74th/stm32-promicro/README.md

# STM32 ProMicro size Board

- STM32F103 -> see [x32micro](https://github.com/74th/x32promicro)
- [STM32G030F6P4](stm32g03xfxp)
- [STM32G431C8U6](stm32g431cxux)
