74th/stm32-promicro/stm32g431cxux/README.md

# STM32G431CxUx ProMicro

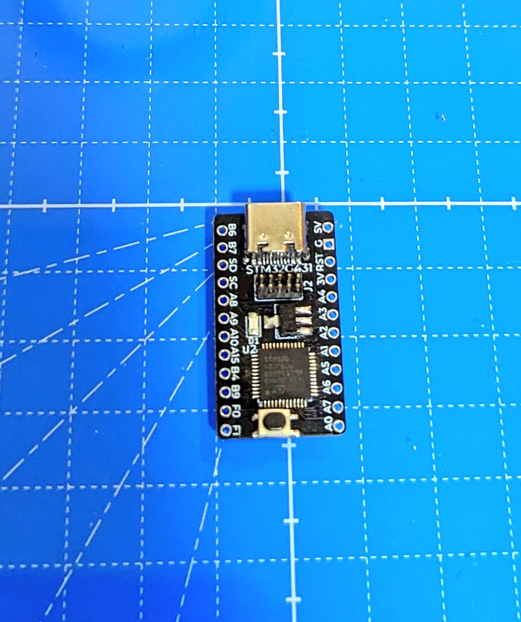
[picture p1: stm32g431cxux/photo1.jpeg]
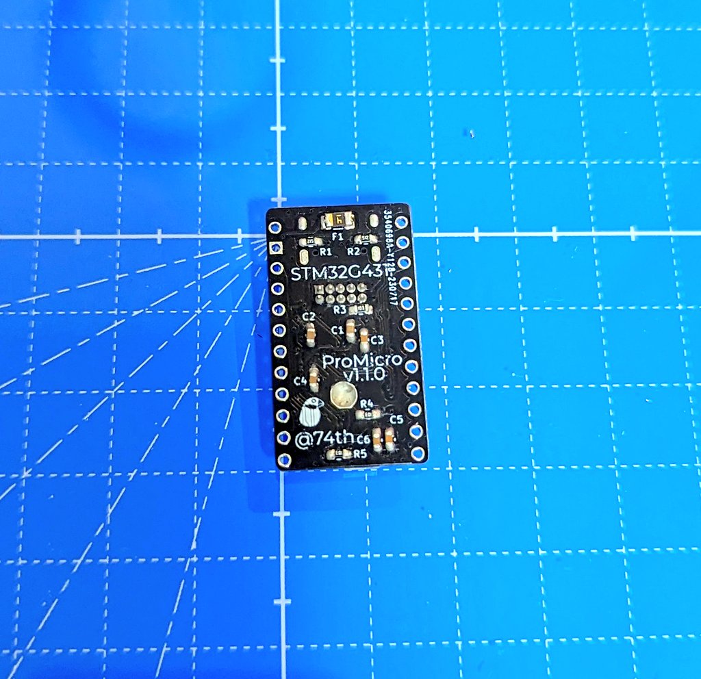
[picture p2: stm32g431cxux/photo2.jpeg]
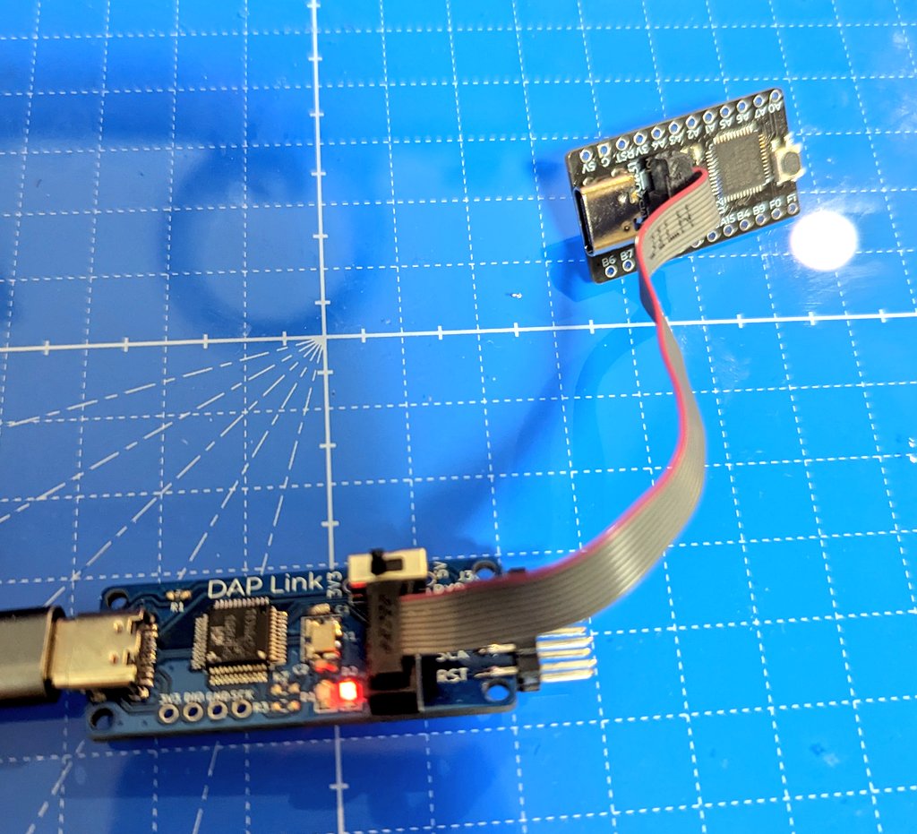
[picture p3: stm32g431cxux/photo3.jpeg]


## v1.1.0

### Documents

- semantics [PDF](./stm32g431-promicro-v1.1.0.pdf) [kicanvas](https://kicanvas.org/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)
- pcb [kicanvas](https://kicanvas.org/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)

### Pin Map

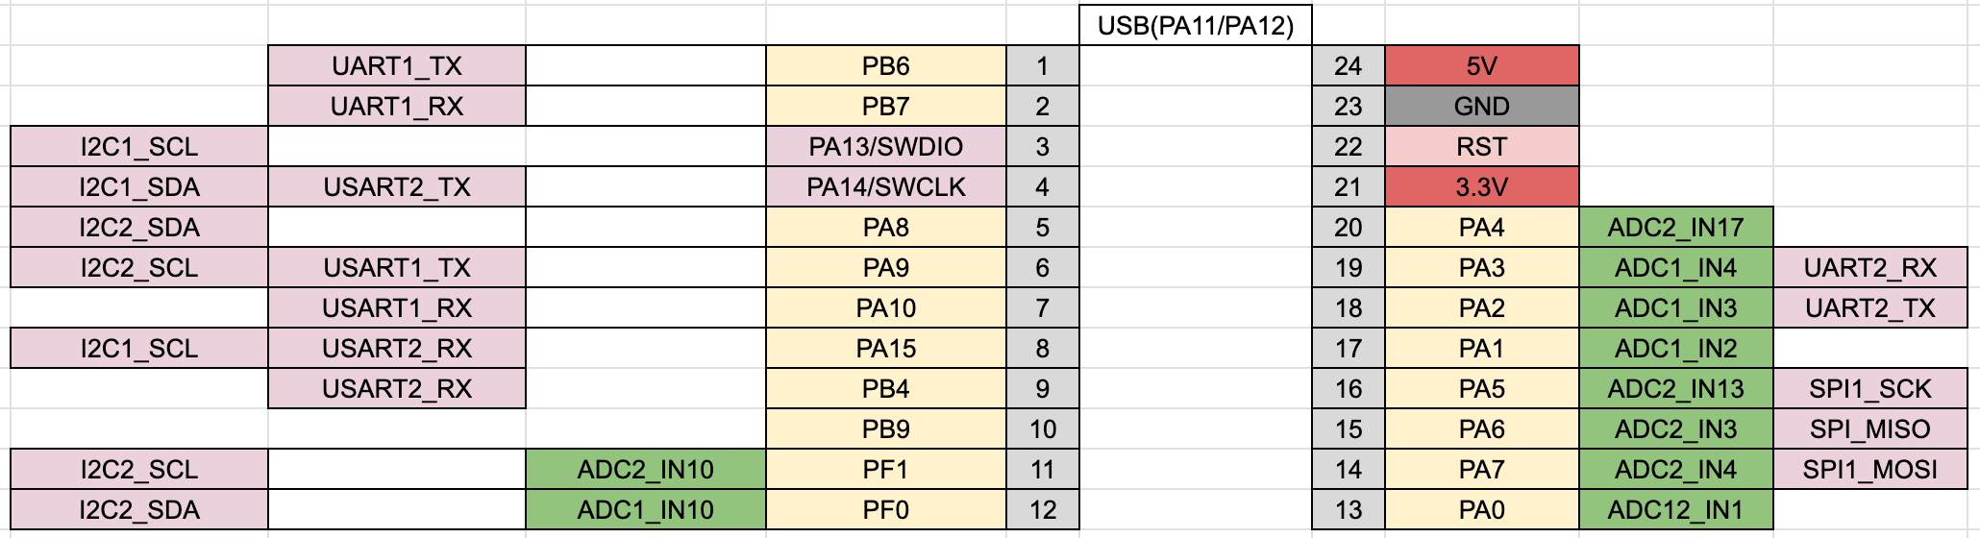
[picture p4: stm32g431cxux/pinmap-v1.1.0.png]


### errorta

- Silk on board has F0 and F1 reversed. ボード上のシルクに F0 と F1 が逆になっています。

### BOM

| Reference | Name | Quantity |
| --- | --- | --- |
| C1, C2 | Capacitor 0603 10uF | 2 |
| C3-C6 | Capacitor 0603 100nF | 4 |
| D1 | LED 0805 Blue | 1 |
| F1 | PolyFuse 1206 Polyfuse | 1 |
| J1 | USB Type-C Receptacle | 1 |
| J2 | Box Pin Header 2x5 Pitch 1.27mm | 1 |
| R1, R2 | Register 0603 5.1kΩ | 2 |
| R3-R5 | Register 0603 10kΩ | 3 |
| SW1 | Button SKRPABE010 | 1 |
| U1 | Regulator 3.3V SOT-89 AMS1117-3.3 | 1 |
| U2 | MCU UFQFPN48 ST STM32G431CBUx | 1 |
