74th/stm32-promicro/stm32g03xfxp/README.md

# STM32F03xfxp ProMicro

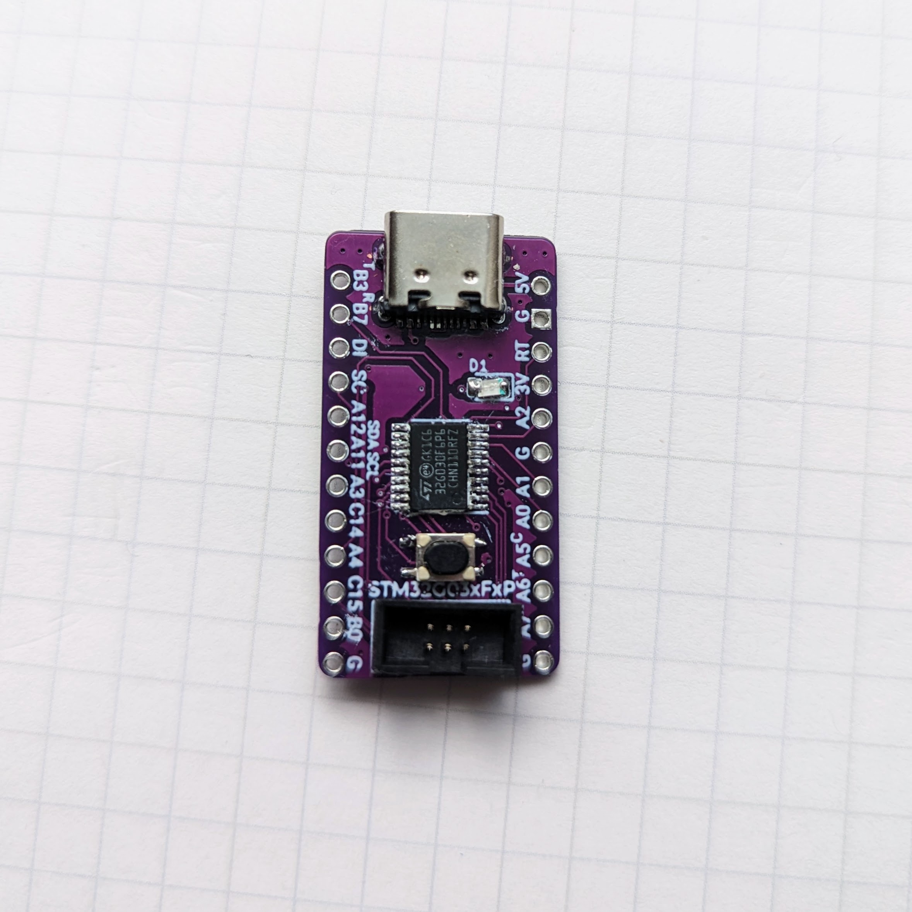
[picture p5: stm32g03xfxp/stm32g03xfxp-v1.2.0-photo1.jpg]
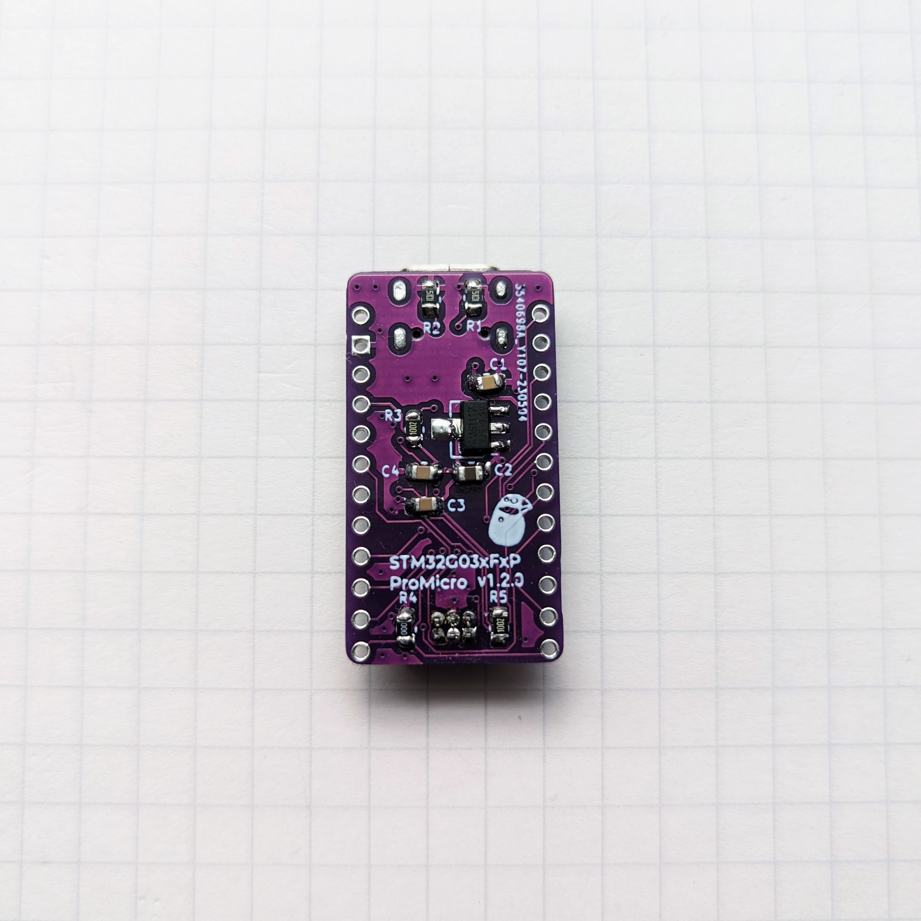
[picture p6: stm32g03xfxp/stm32g03xfxp-v1.2.0-photo2.jpg]
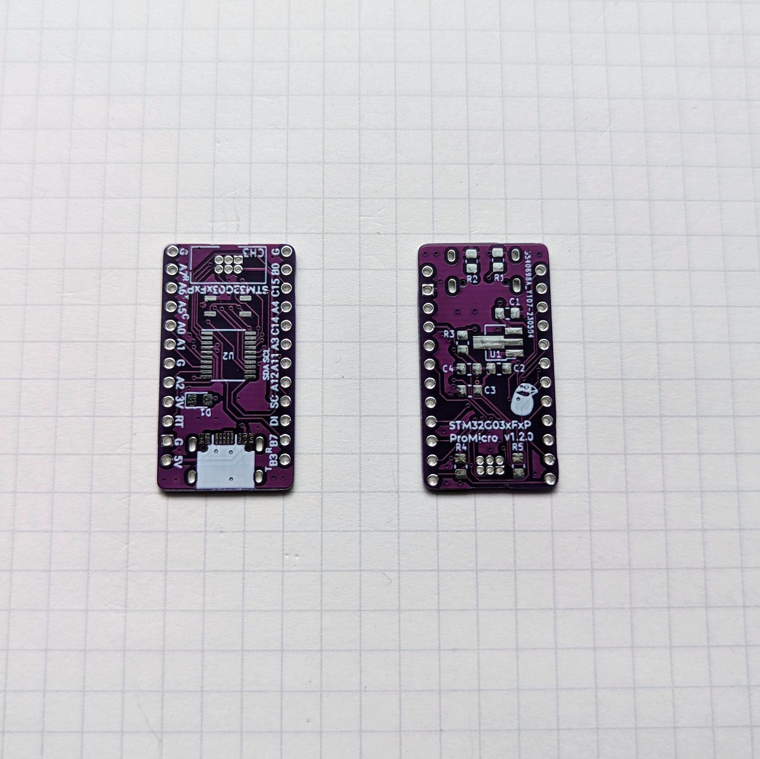
[picture p7: stm32g03xfxp/stm32g03xfxp-v1.2.0-photo3.jpg]
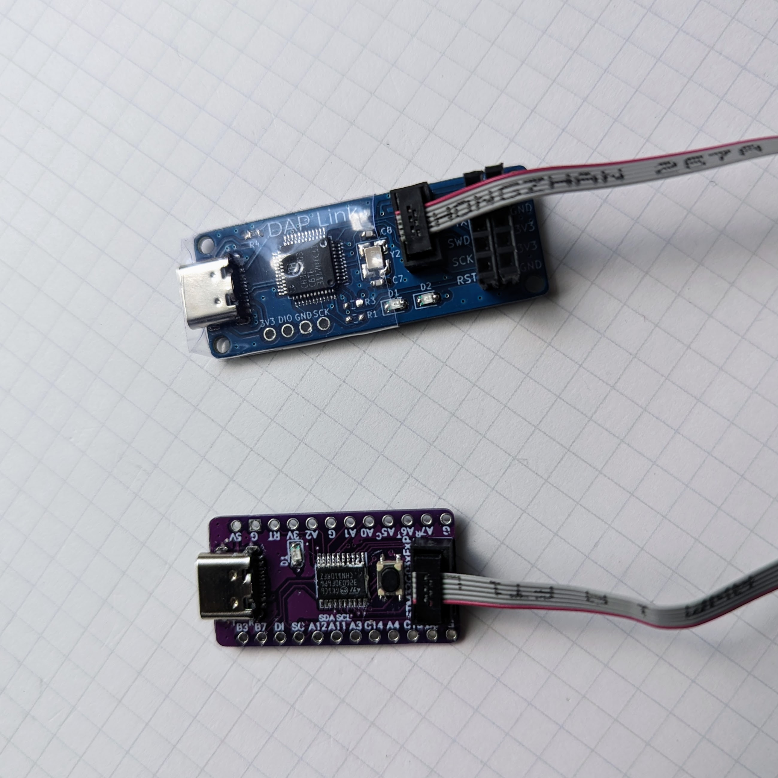
[picture p8: stm32g03xfxp/stm32g03xfxp-v1.2.0-photo4.jpg]


## v1.3.0

- change SWD port to 10 Pin with UART like Arduino UNO R4 (but, vcc is 3.3V)

### Documents

- Semantics 回路図 [PDF](stm32g03xfxp-semantcs-v1.3.0.pdf) [kicanvas](https://kicanvas.org/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)
- PCB [kicanvas](https://kicanvas.org/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)

### Debug Port

The box pin header for SWD has the following pin layout.

SWD のピンヘッダは以下のピン配置になっています。

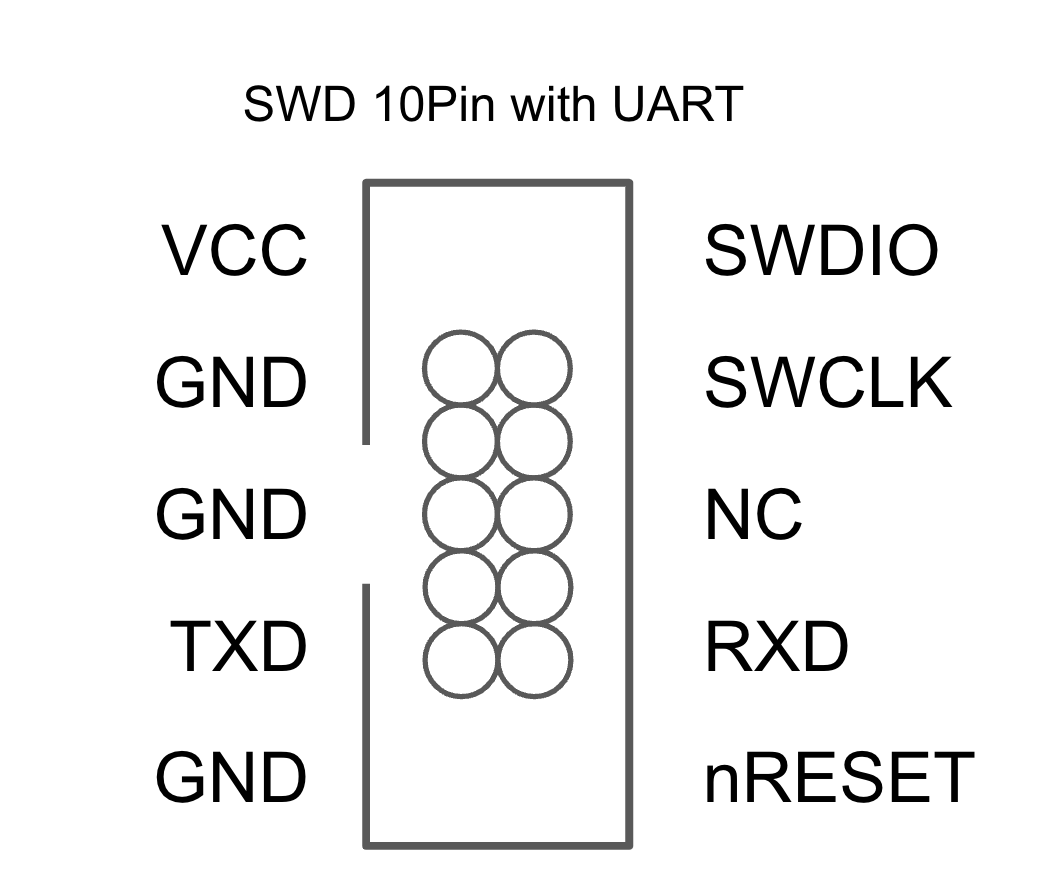
[picture p9: swd-with-uart-10pin.png]


## Pinout

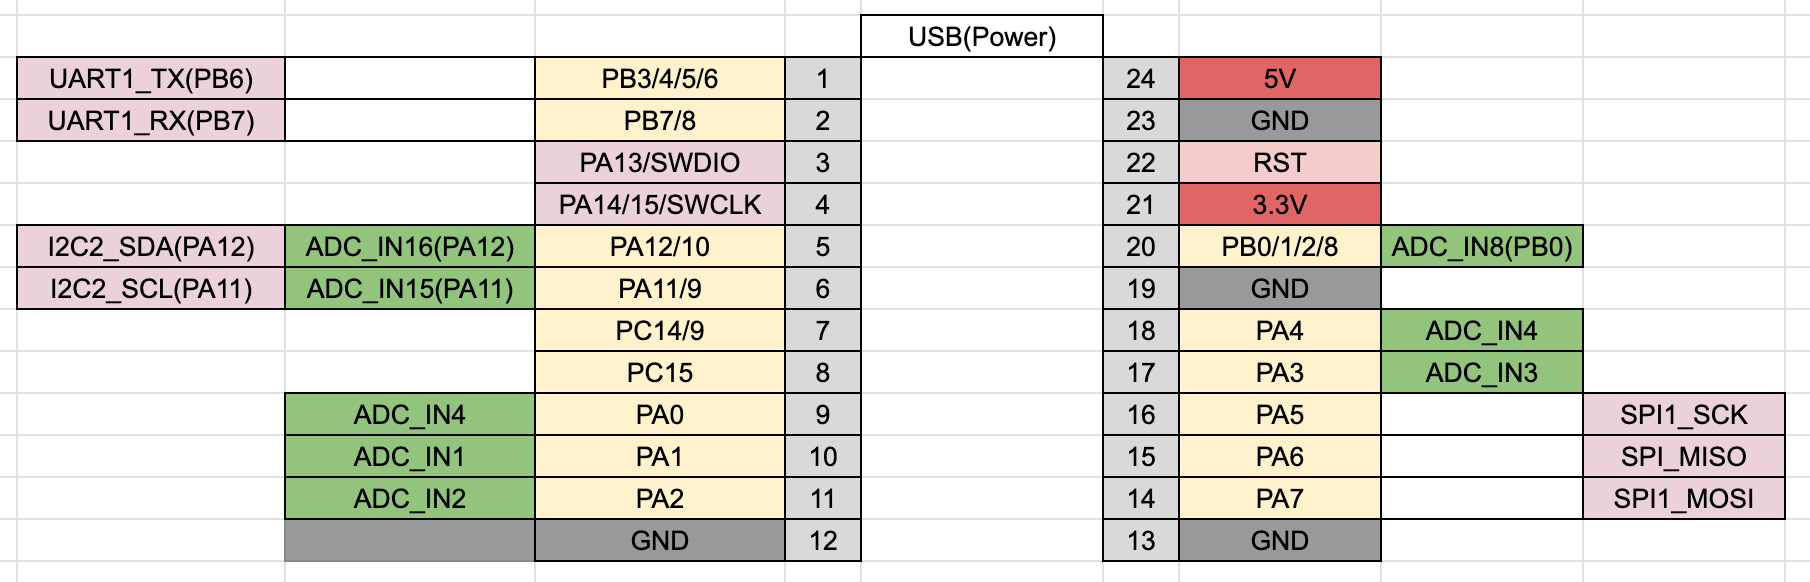
[picture p10: stm32g03xfxp/pinmap-v1.3.0.png]


For other functions, please refer to the datasheet.

他の機能はデータシートを参照ください。

### BOM

| Reference | Name | Quantity |
| --- | --- | --- |
| C1 | Capacitor 0805 10uF | 1 |
| C2 | Capacitor 0805 2.2uF | 1 |
| C3, C4 | Capacitor 0805 100nF | 2 |
| D1 | LED 0805 Blue | 1 |
| J1 | USB Type-C Receptacle | 1 |
| J2 | Pin Header 2x5 Pitch 1.27mm (SWD) | 1 |
| R1, R2 | Register 0805 5.1kΩ | 2 |
| R3, R4 | Register 0805 10kΩ | 2 |
| SW1 | Button SKRPABE010 | 1 |
| U1 | Regulator 3.3V SOT-89 AMS1117 | 1 |
| U2 | MCU ST STM32G030F6Px | 1 |

## v1.2.0

### Documents

- Semantics 回路図 [PDF](stm32g03xfxp-semantcs-v1.2.0.pdf) [kicanvas](https://kicanvas.org/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)
- PCB [PDF](stm32g03xfxp-pcb.pdf) [kicanvas](https://kicanvas.org/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)

### Debug Port

The box pin header for DAP Link has the following pin layout.

DAP Link 用のボックスピンヘッダは以下のピン配置になっています。

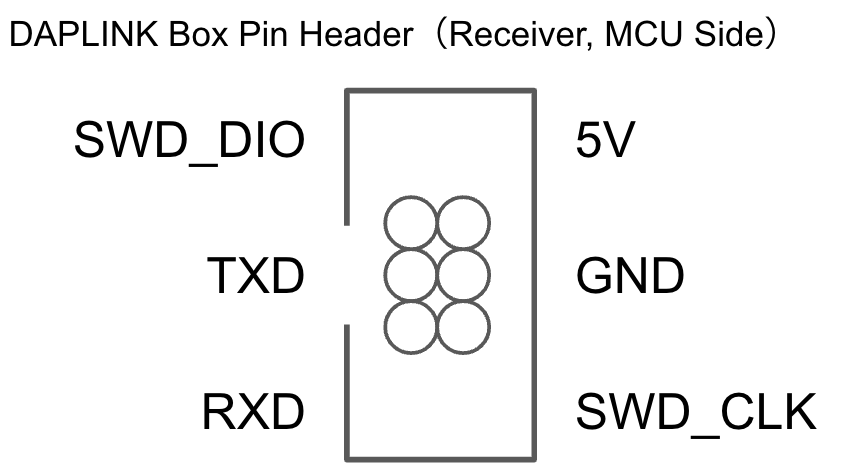
[picture p11: daplink-boxpinheader-receiver-6pin.png]


### Pinout

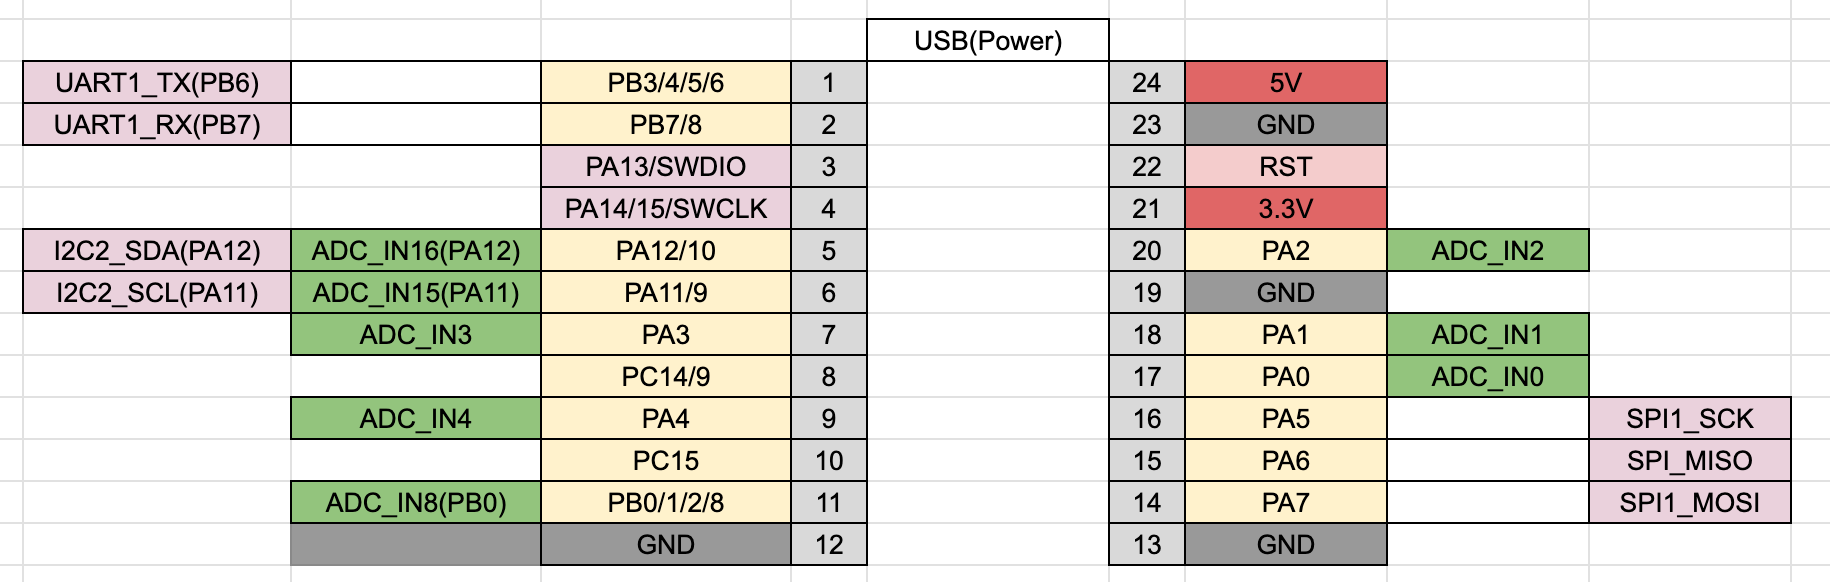
[picture p12: stm32g03xfxp/pinmap-v1.2.0.png]


For other functions, please refer to the datasheet.

他の機能はデータシートを参照ください。

### BOM

| id | parts name | num |
| ----- | --- | --- |
| J1 | USB 2.0 Type-C Socket (Only Power) | 1 |
| R1,R2 | 0806 Register 5.1k | 2 |
| R4 | 0806 Register 0 | 1 |
| R3,R6 | 0806 Register 10k | 2 |
| C1 | 0806 Capacitor 10u | 1 |
| C2 | 0806 Capacitor 2.2u | 1 |
| C3,C4 | 0806 Capacitor 100n | 2 |
| U2 | TSSOP-20 MCU STM32G030F6Px | 1 |
| D1 | 0805 LED Blue | 1 |
| U1 | SOT-89 3.3V Regulator AMS1117-3.3 | 1 |
| SW1 | SKRPABE010 Push Switch | 1 |
| CH3 | Pitch 1.25mm 2x3 Box Pin Header DAPLink-SWD | 1 |
