74th/stm32-promicro/stm32g431cxux/stm32g431-promicro-v1.1.0.pdf

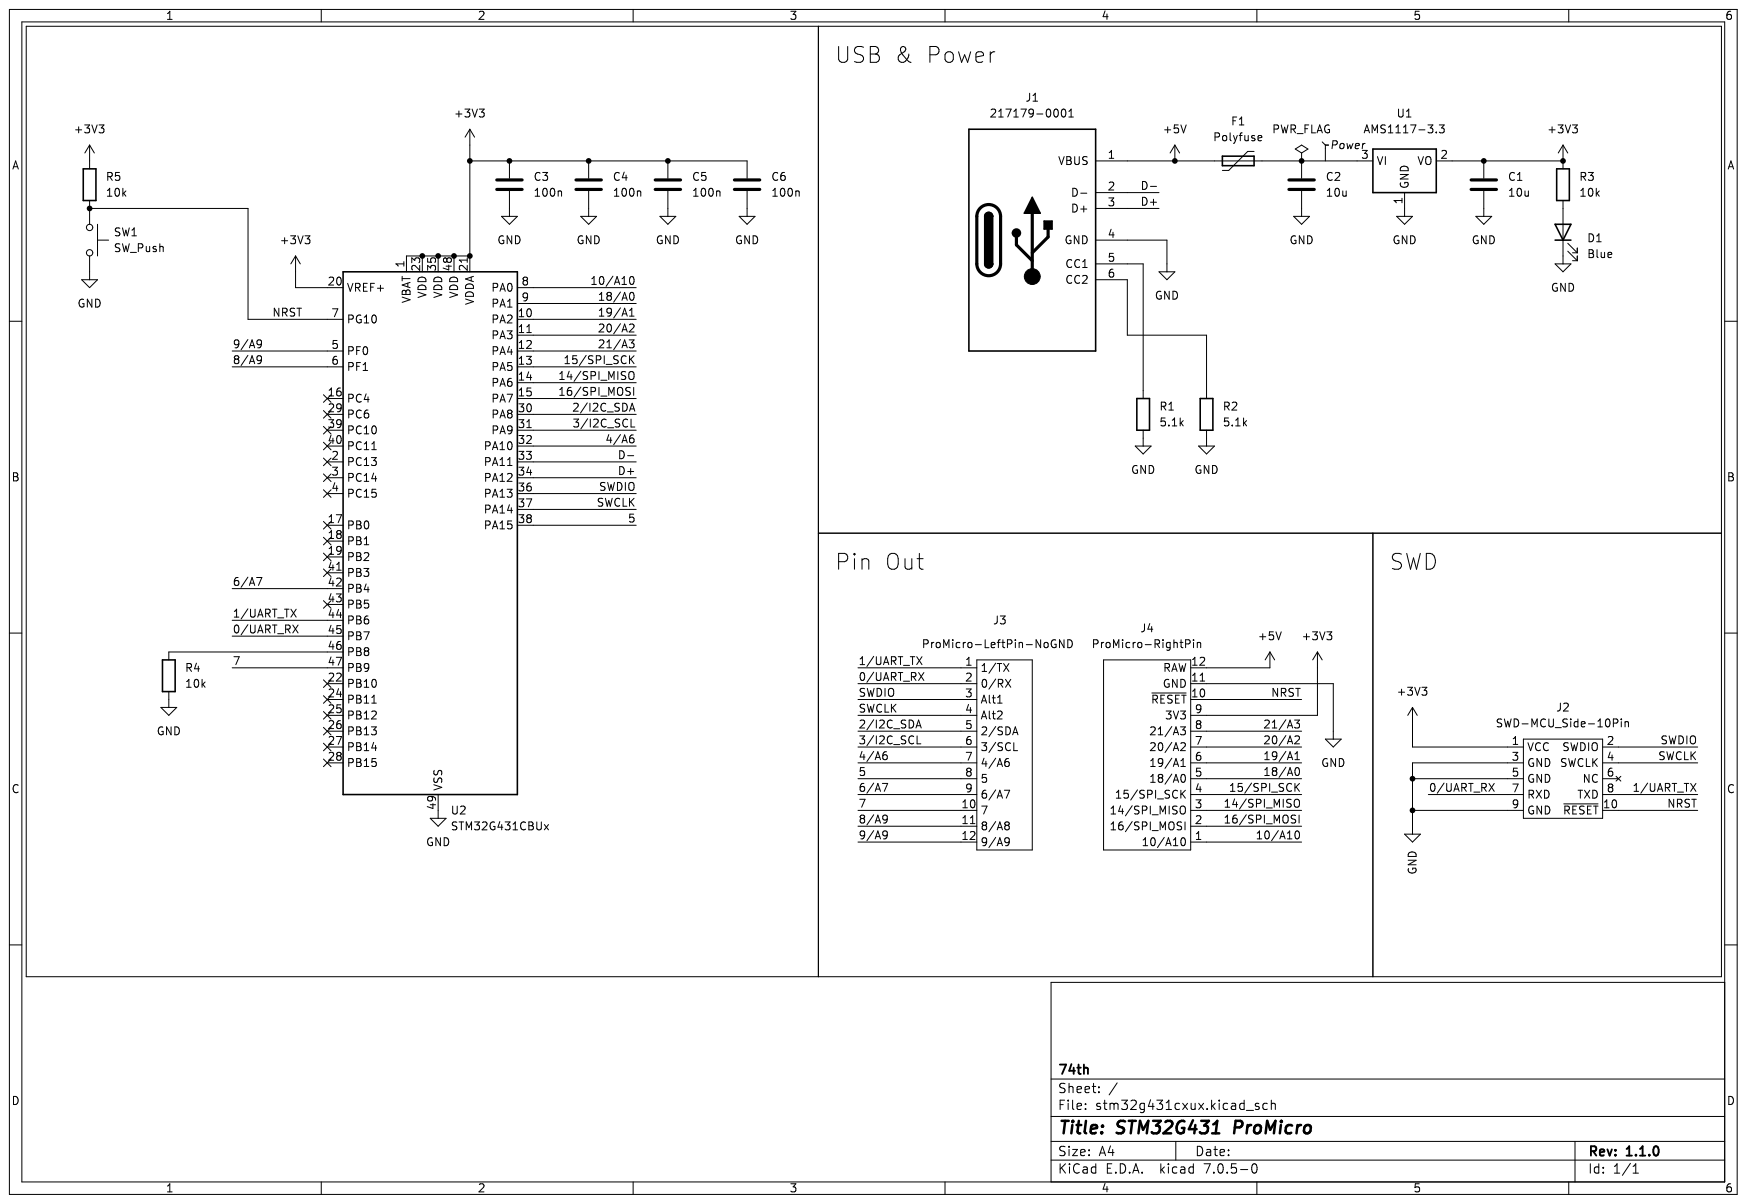
[picture p13: page 1]
