74th/stm32-promicro/stm32g03xfxp/stm32g03xfxp-semantcs-v1.3.0.pdf

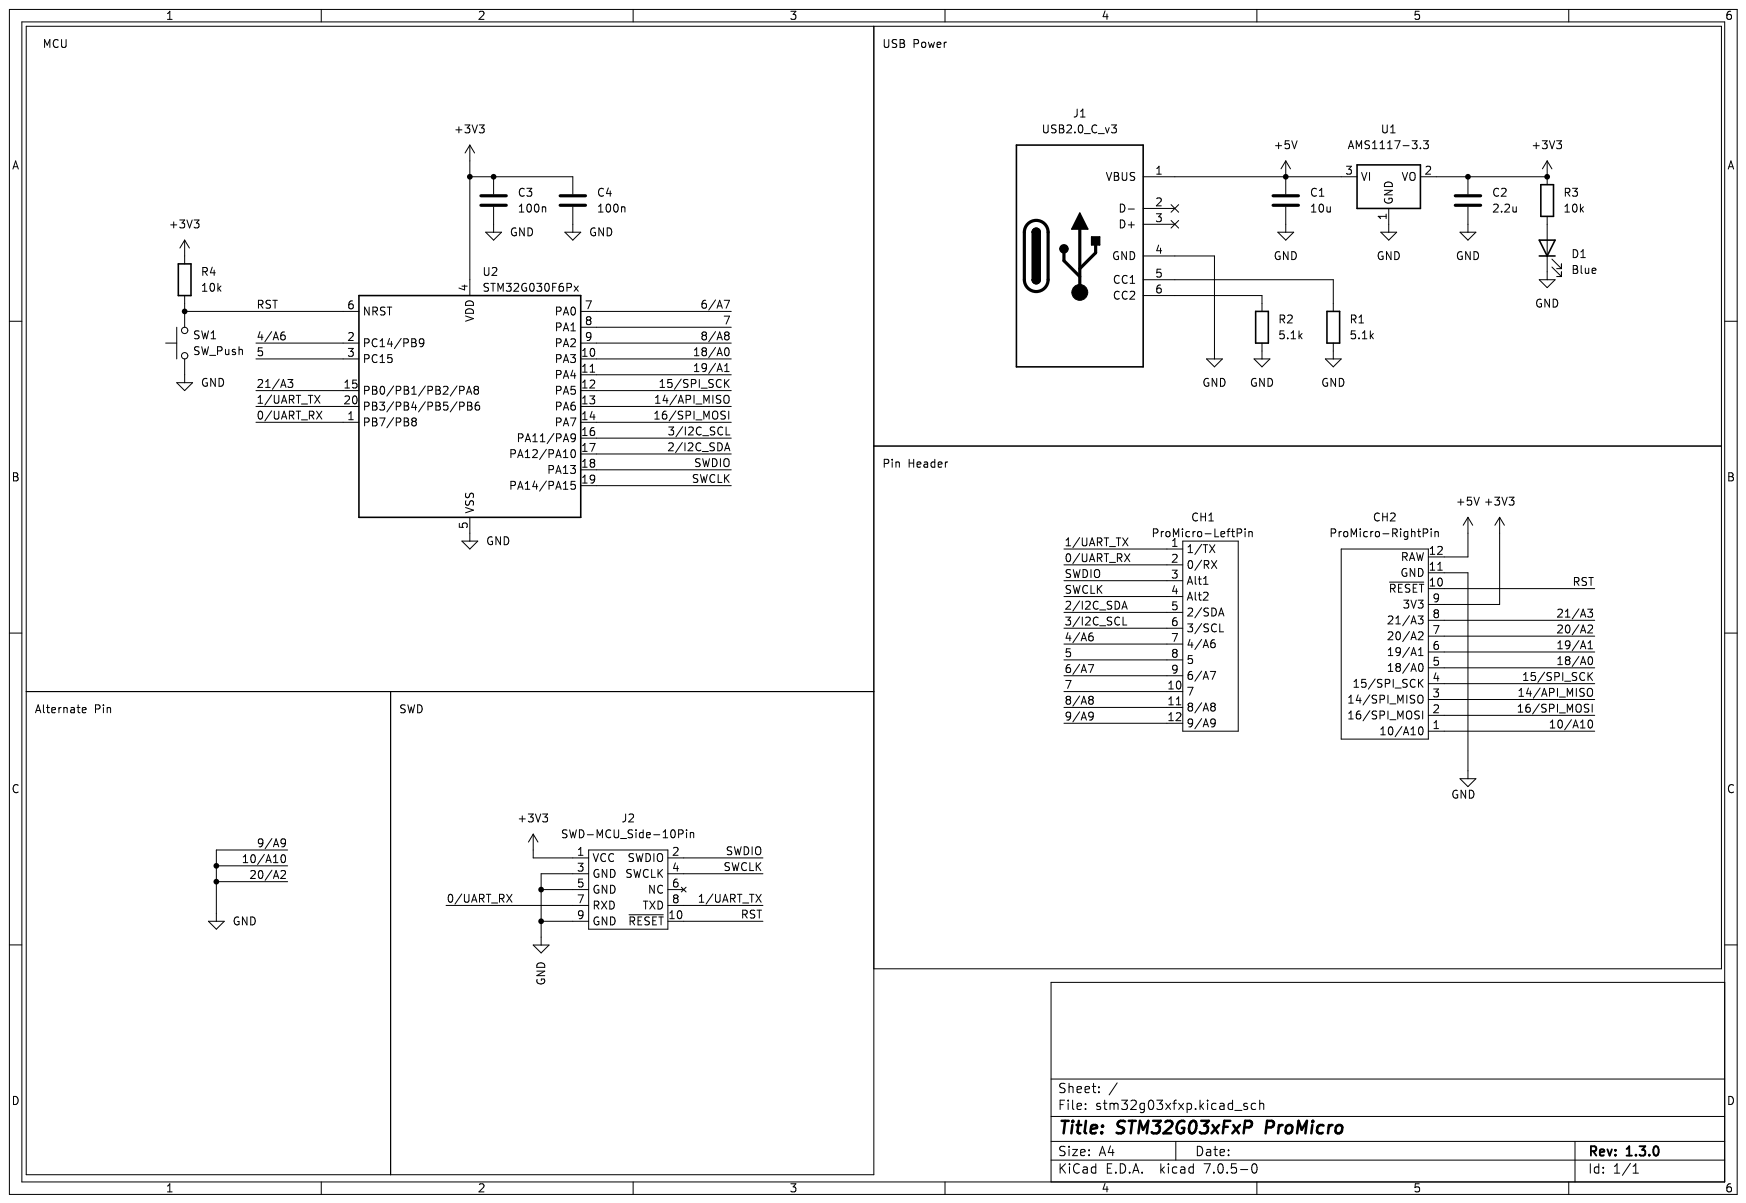
[picture p14: page 1]
