74th/stm32-promicro/stm32g03xfxp/stm32g03xfxp-semantcs-v1.2.0.pdf

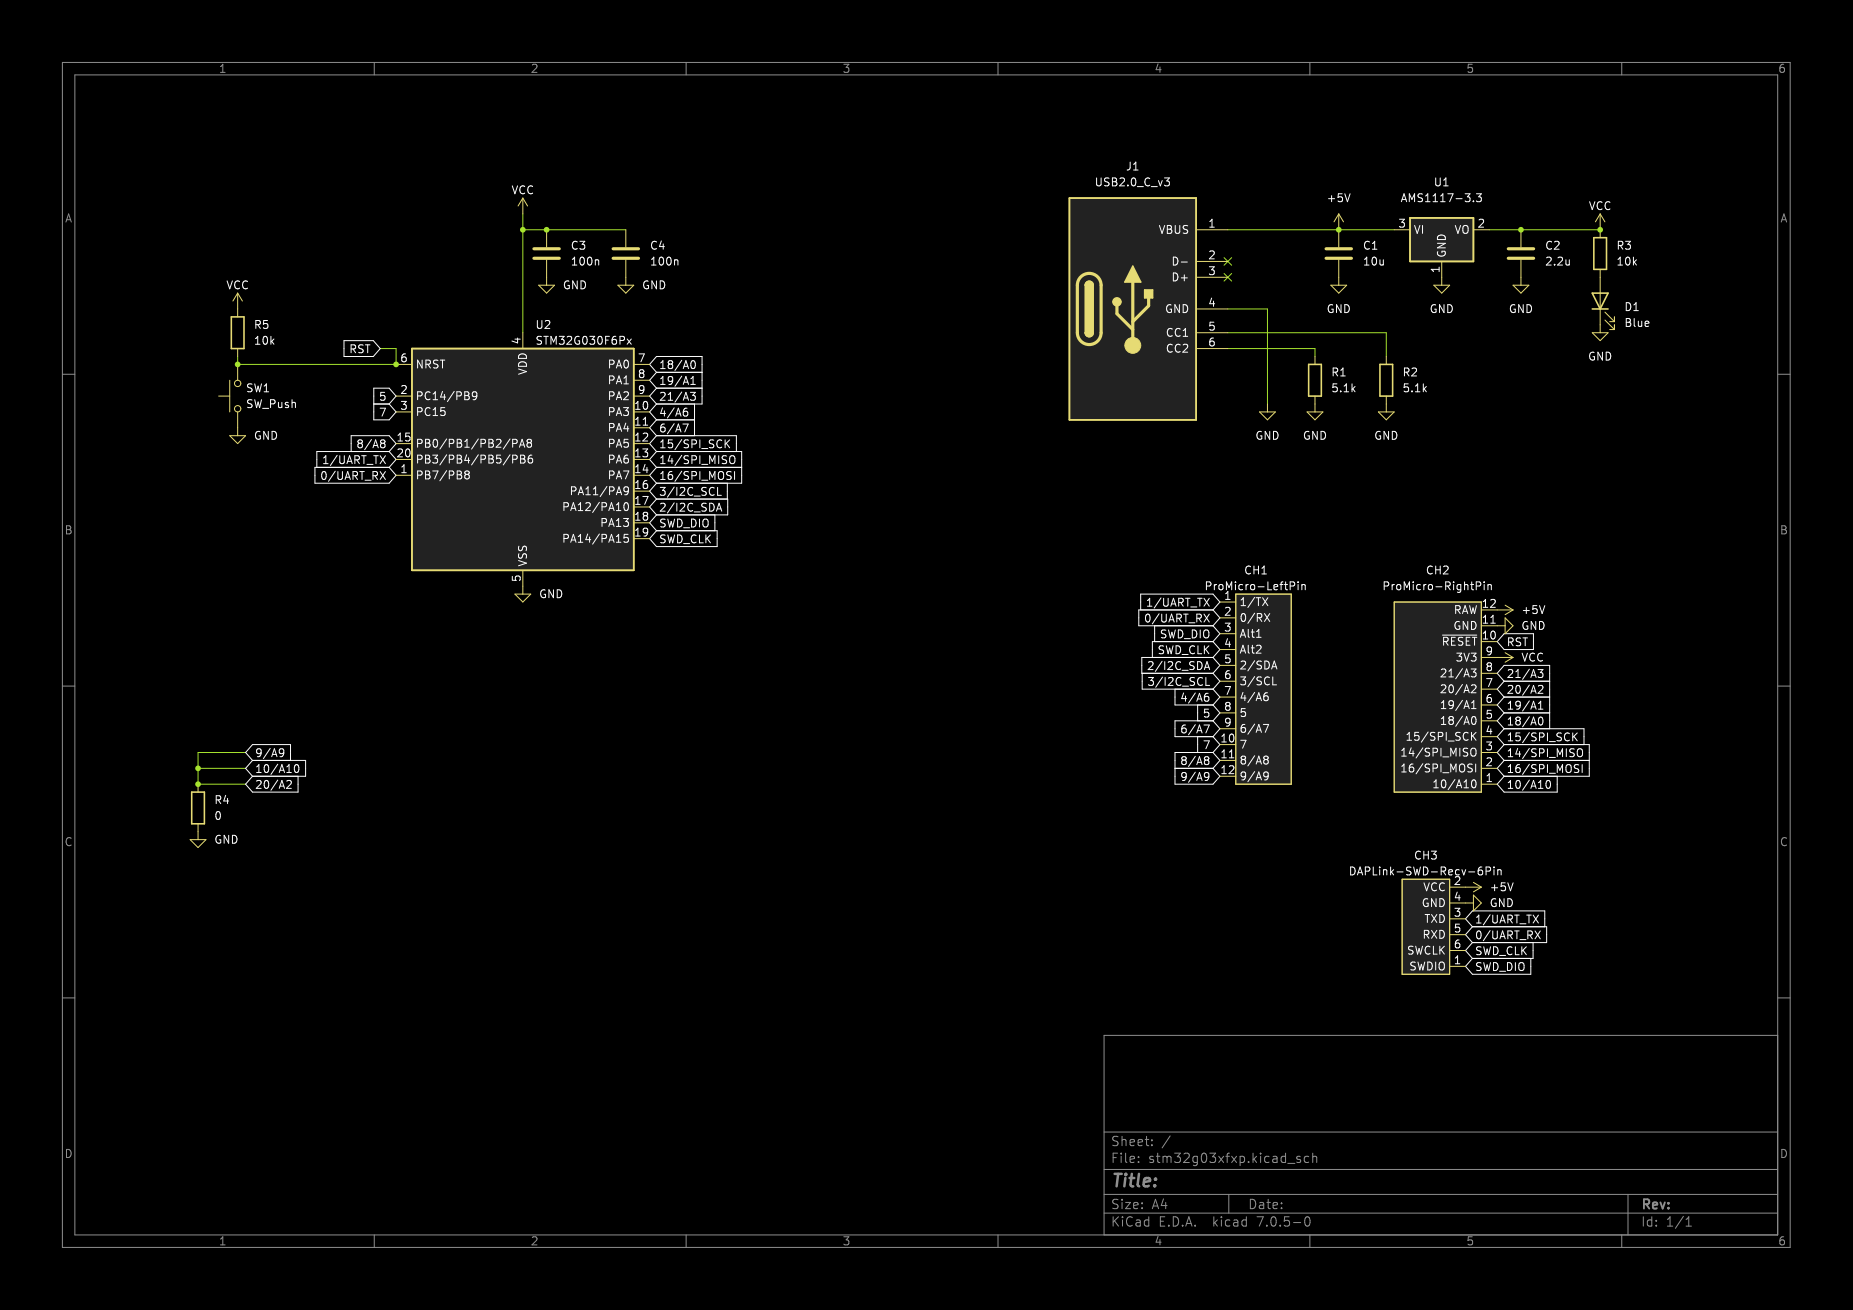
[picture p23: page 1]
