74th/stm32-promicro/stm32g431cxux/stm32g431cxux.kicad_pcb

## KiCad design stm32g431cxux/stm32g431cxux.kicad_pcb (2023-08-20)

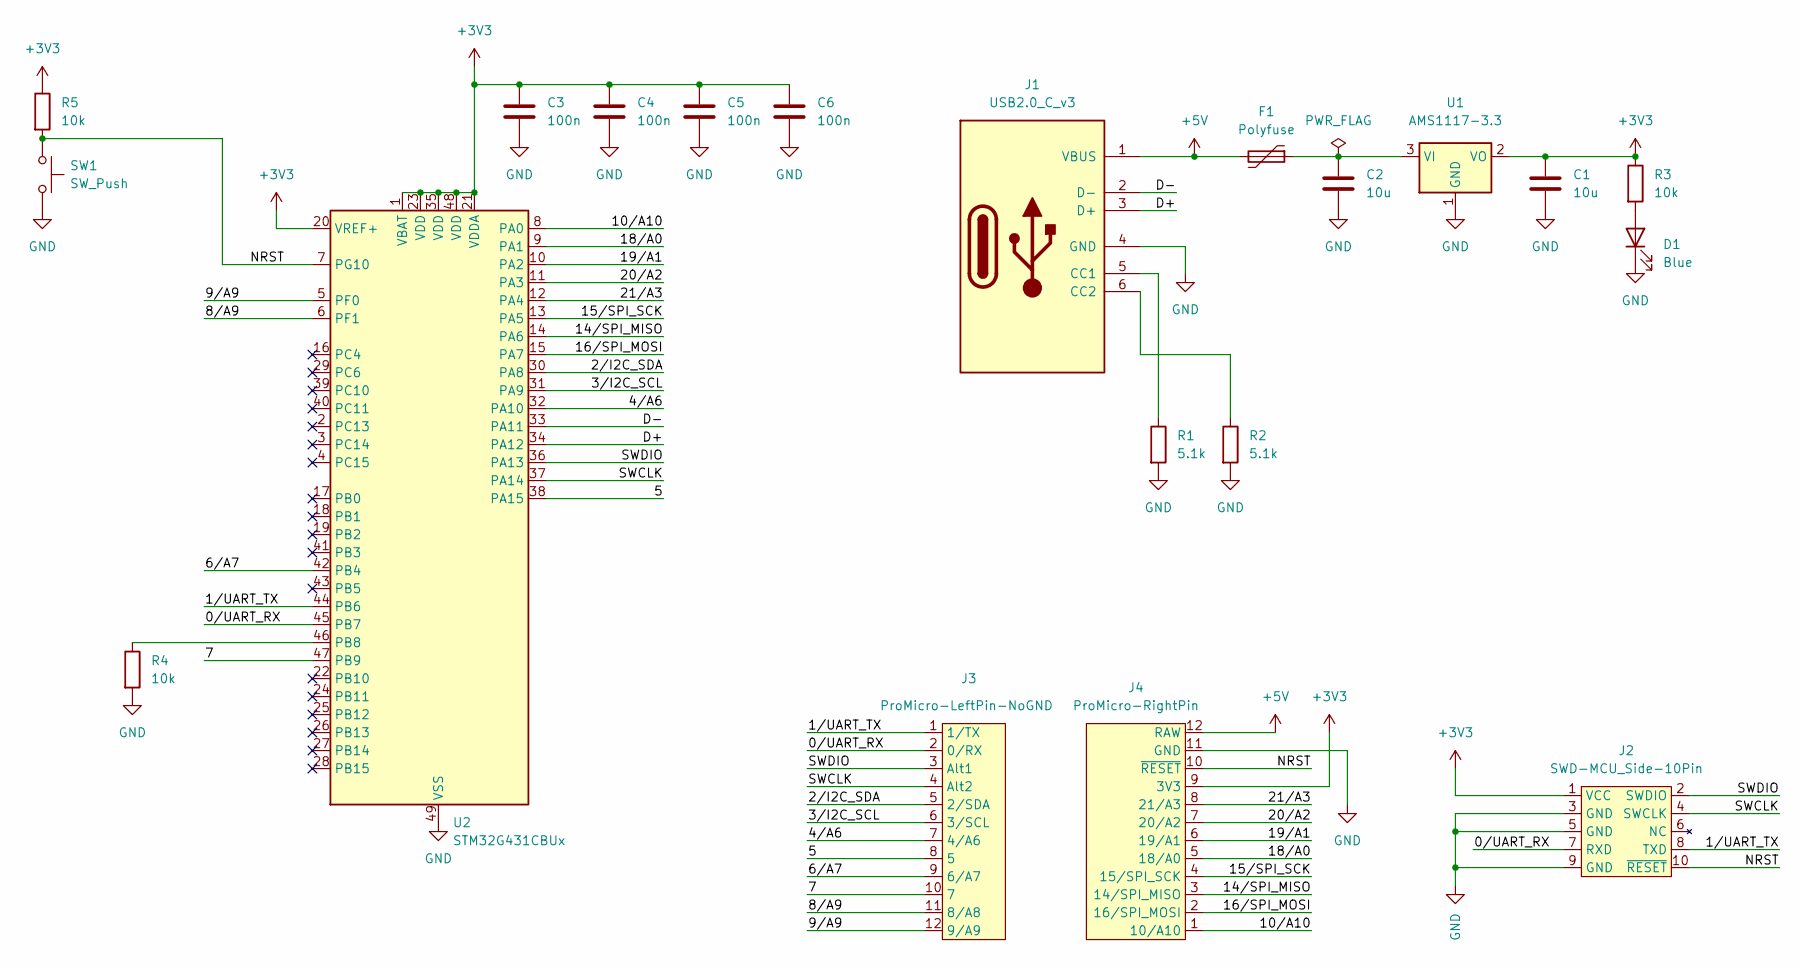
[picture p24: schematic stm32g431cxux.kicad_sch]

Parts:
C1, C2: 10u; Capacitor_0603_1608
C3, C4, C5, C6: 100n; Capacitor_0603_1608
D1: Blue; LED_0805_2012Metric_Pad1.15x1.40mm_HandSolder
F1: Polyfuse; Fuse_1206_3216Metric
J1: USB2.0_C_v3; USB-C-12-Pin-SMD
J2: SWD-MCU_Side-10Pin; SWD_2x05_P1.27mm
J3: ProMicro-LeftPin-NoGND; ProMicro_LIKE_LEFT_NO_GND
J4: ProMicro-RightPin; ProMicro_LIKE_RIGHT
R1, R2: 5.1k; Register_0603_1608
R3, R4, R5: 10k; Register_0603_1608
SW1: SW_Push; SKRPABE010
U1: AMS1117-3.3; SOT-89-3_Handsoldering
U2: STM32G431CBUx; QFN-48-1EP_7x7mm_P0.5mm_EP5.6x5.6mm

Connections:
+3V3: C1.1, C3.1, C4.1, C5.1, C6.1, J2.1 (VCC), J4.9 (3V3), R3.1, R5.1, U1.2 (VO), U2.1 (VBAT), U2.20 (VREF+), U2.21 (VDDA), U2.23 (VDD), U2.35 (VDD), U2.48 (VDD)
+5V: F1.2, J1.1 (VBUS), J4.12 (RAW)
/0/UART_RX: J2.7 (RXD), J3.2 (0/RX), U2.45 (PB7)
/1/UART_TX: J2.8 (TXD), J3.1 (1/TX), U2.44 (PB6)
/2/I2C_SDA: J3.5 (2/SDA), U2.30 (PA8)
/3/I2C_SCL: J3.6 (3/SCL), U2.31 (PA9)
/4/A6: J3.7 (4/A6), U2.32 (PA10)
/5: J3.8 (5), U2.38 (PA15)
/6/A7: J3.9 (6/A7), U2.42 (PB4)
/7: J3.10 (7), U2.47 (PB9)
/8/A9: J3.11 (8/A8), U2.6 (PF1)
/9/A9: J3.12 (9/A9), U2.5 (PF0)
/10/A10: J4.1 (10/A10), U2.8 (PA0)
/14/SPI_MISO: J4.3 (14/SPI_MISO), U2.14 (PA6)
/15/SPI_SCK: J4.4 (15/SPI_SCK), U2.13 (PA5)
/16/SPI_MOSI: J4.2 (16/SPI_MOSI), U2.15 (PA7)
/18/A0: J4.5 (18/A0), U2.9 (PA1)
/19/A1: J4.6 (19/A1), U2.10 (PA2)
/20/A2: J4.7 (20/A2), U2.11 (PA3)
/21/A3: J4.8 (21/A3), U2.12 (PA4)
/D+: J1.3 (D+), U2.34 (PA12)
/D-: J1.2 (D-), U2.33 (PA11)
/NRST: J2.10 (~RESET), J4.10 (~RESET), R5.2, SW1.1, U2.7 (PG10)
/SWCLK: J2.4 (SWCLK), J3.4 (Alt2), U2.37 (PA14)
/SWDIO: J2.2 (SWDIO), J3.3 (Alt1), U2.36 (PA13)
GND: C1.2, C2.2, C3.2, C4.2, C5.2, C6.2, D1.1 (K), J1.4 (GND), J2.3 (GND), J2.5 (GND), J2.9 (GND), J4.11 (GND), R1.2, R2.2, R4.2, SW1.2, U1.1 (GND), U2.49 (VSS)
unnamed: D1.2 (A), R3.2
unnamed: J1.5 (CC1), R1.1
unnamed: J1.6 (CC2), R2.1
unnamed: C2.1, F1.1, U1.3 (VI)
unnamed: R4.1, U2.46 (PB8)

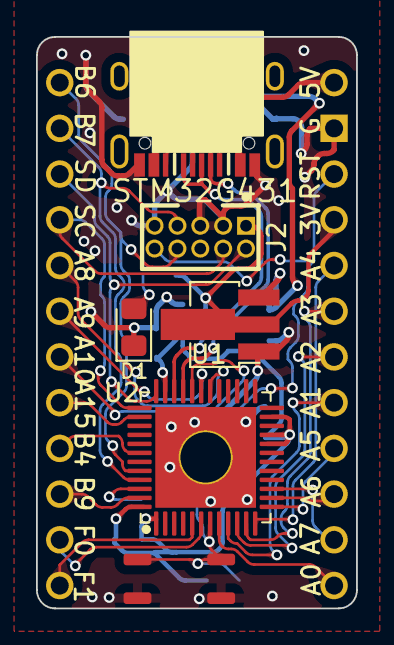
[picture p25: board stm32g431cxux.kicad_pcb from above]

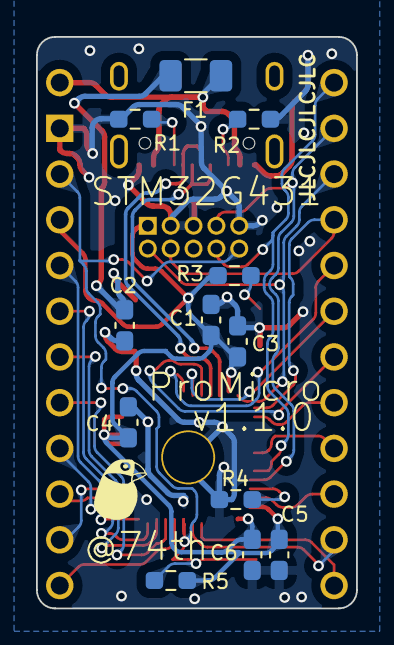
[picture p26: board stm32g431cxux.kicad_pcb from below]

Board: 2 copper layers, 17.8 x 31.8 mm, 20 parts (12 on the bottom side), 31 nets.
