74th/stm32-promicro/stm32g03xfxp/stm32g03xfxp.kicad_pcb

## KiCad design stm32g03xfxp/stm32g03xfxp.kicad_pcb (2023-08-20)

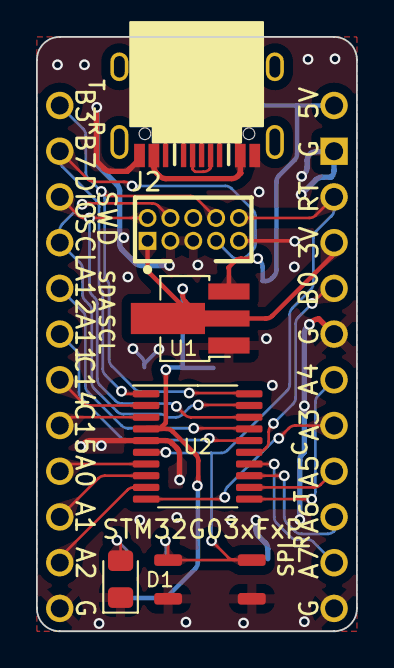
[picture p27: board stm32g03xfxp.kicad_pcb from above]

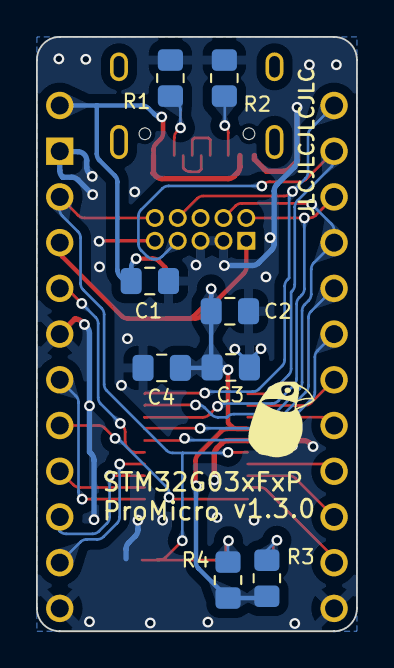
[picture p28: board stm32g03xfxp.kicad_pcb from below]

Board: 2 copper layers, 17.8 x 33.0 mm, 17 parts (9 on the bottom side), 24 nets.

Parts:
C1: 10u; Capacitor_0805_2012
C2: 2.2u; Capacitor_0805_2012
C3, C4: 100n; Capacitor_0805_2012
CH1: ProMicro-LeftPin; ProMicro_LIKE_LEFT_NO_GND
CH2: ProMicro-RightPin; ProMicro_LIKE_RIGHT
D1: Blue; LED_0805_2012Metric_Pad1.15x1.40mm_HandSolder
G1: LOGO; 74th-5mm
J1: USB2.0_C_v3; USB-C-12-Pin-SMD
J2: SWD-MCU_Side-10Pin; SWD_2x05_P1.27mm
R1, R2: 5.1k; Register_0805_2012
R3, R4: 10k; Register_0805_2012
SW1: SW_Push; SKRPABE010
U1: AMS1117-3.3; Regulator_AMS1117_SOT-89
U2: STM32G030F6Px; TSSOP-20_4.4x6.5mm_P0.65mm

Connections:
+3V3: C2.1, C3.1, C4.1, CH2.9 (3V3), J2.1 (VCC), R3.1, R4.1, U1.2 (VO), U2.4 (VDD)
+5V: C1.1, CH2.12 (RAW), J1.1 (VBUS), U1.3 (VI)
/0/UART_RX: CH1.2 (0/RX), J2.7 (RXD), U2.1 (PB7/PB8)
/1/UART_TX: CH1.1 (1/TX), J2.8 (TXD), U2.20 (PB3/PB4/PB5/PB6)
/2/I2C_SDA: CH1.5 (2/SDA), U2.17 (PA12/PA10)
/3/I2C_SCL: CH1.6 (3/SCL), U2.16 (PA11/PA9)
/4/A6: CH1.7 (4/A6), U2.2 (PC14/PB9)
/5: CH1.8 (5), U2.3 (PC15)
/6/A7: CH1.9 (6/A7), U2.7 (PA0)
/7: CH1.10 (7), U2.8 (PA1)
/8/A8: CH1.11 (8/A8), U2.9 (PA2)
/14/API_MISO: CH2.3 (14/SPI_MISO), U2.13 (PA6)
/15/SPI_SCK: CH2.4 (15/SPI_SCK), U2.12 (PA5)
/16/SPI_MOSI: CH2.2 (16/SPI_MOSI), U2.14 (PA7)
/18/A0: CH2.5 (18/A0), U2.10 (PA3)
/19/A1: CH2.6 (19/A1), U2.11 (PA4)
/21/A3: CH2.8 (21/A3), U2.15 (PB0/PB1/PB2/PA8)
/RST: CH2.10 (~RESET), J2.10 (~RESET), R4.2, SW1.2, U2.6 (NRST)
/SWCLK: CH1.4 (Alt2), J2.4 (SWCLK), U2.19 (PA14/PA15)
/SWDIO: CH1.3 (Alt1), J2.2 (SWDIO), U2.18 (PA13)
GND: C1.2, C2.2, C3.2, C4.2, CH1.12 (9/A9), CH2.1 (10/A10), CH2.7 (20/A2), CH2.11 (GND), D1.1 (K), J1.4 (GND), J2.3 (GND), J2.5 (GND), J2.9 (GND), R1.2, R2.2, SW1.1, U1.1 (GND), U2.5 (VSS)
unnamed: D1.2 (A), R3.2
unnamed: J1.5 (CC1), R1.1
unnamed: J1.6 (CC2), R2.1
