74th/stm32-promicro/(commit log)

2023-04-08 before routing
    [stm32g03xfxp.kicad_pcb, stm32g03xfxp.kicad_sch]
2023-04-19 fix dio/clk
    [stm32g03xfxp.kicad_pcb, stm32g03xfxp.kicad_sch]
2023-06-18 before free routing
    [stm32g431cxux.kicad_pcb, stm32g431cxux.kicad_sch]
2023-06-18 after free routing
    [stm32g431cxux.kicad_pcb]
2023-10-06 update metadata
    [stm32g03xfxp.kicad_sch]
2023-10-06 update semantics
    [stm32g431cxux.csv, stm32g431cxux.kicad_sch]
